sandrews/freETarget/KiCad/Main Board/Electronic Target V3.sch

## KiCad design KiCad/Main Board/Electronic Target V3.sch (2021-02-10)

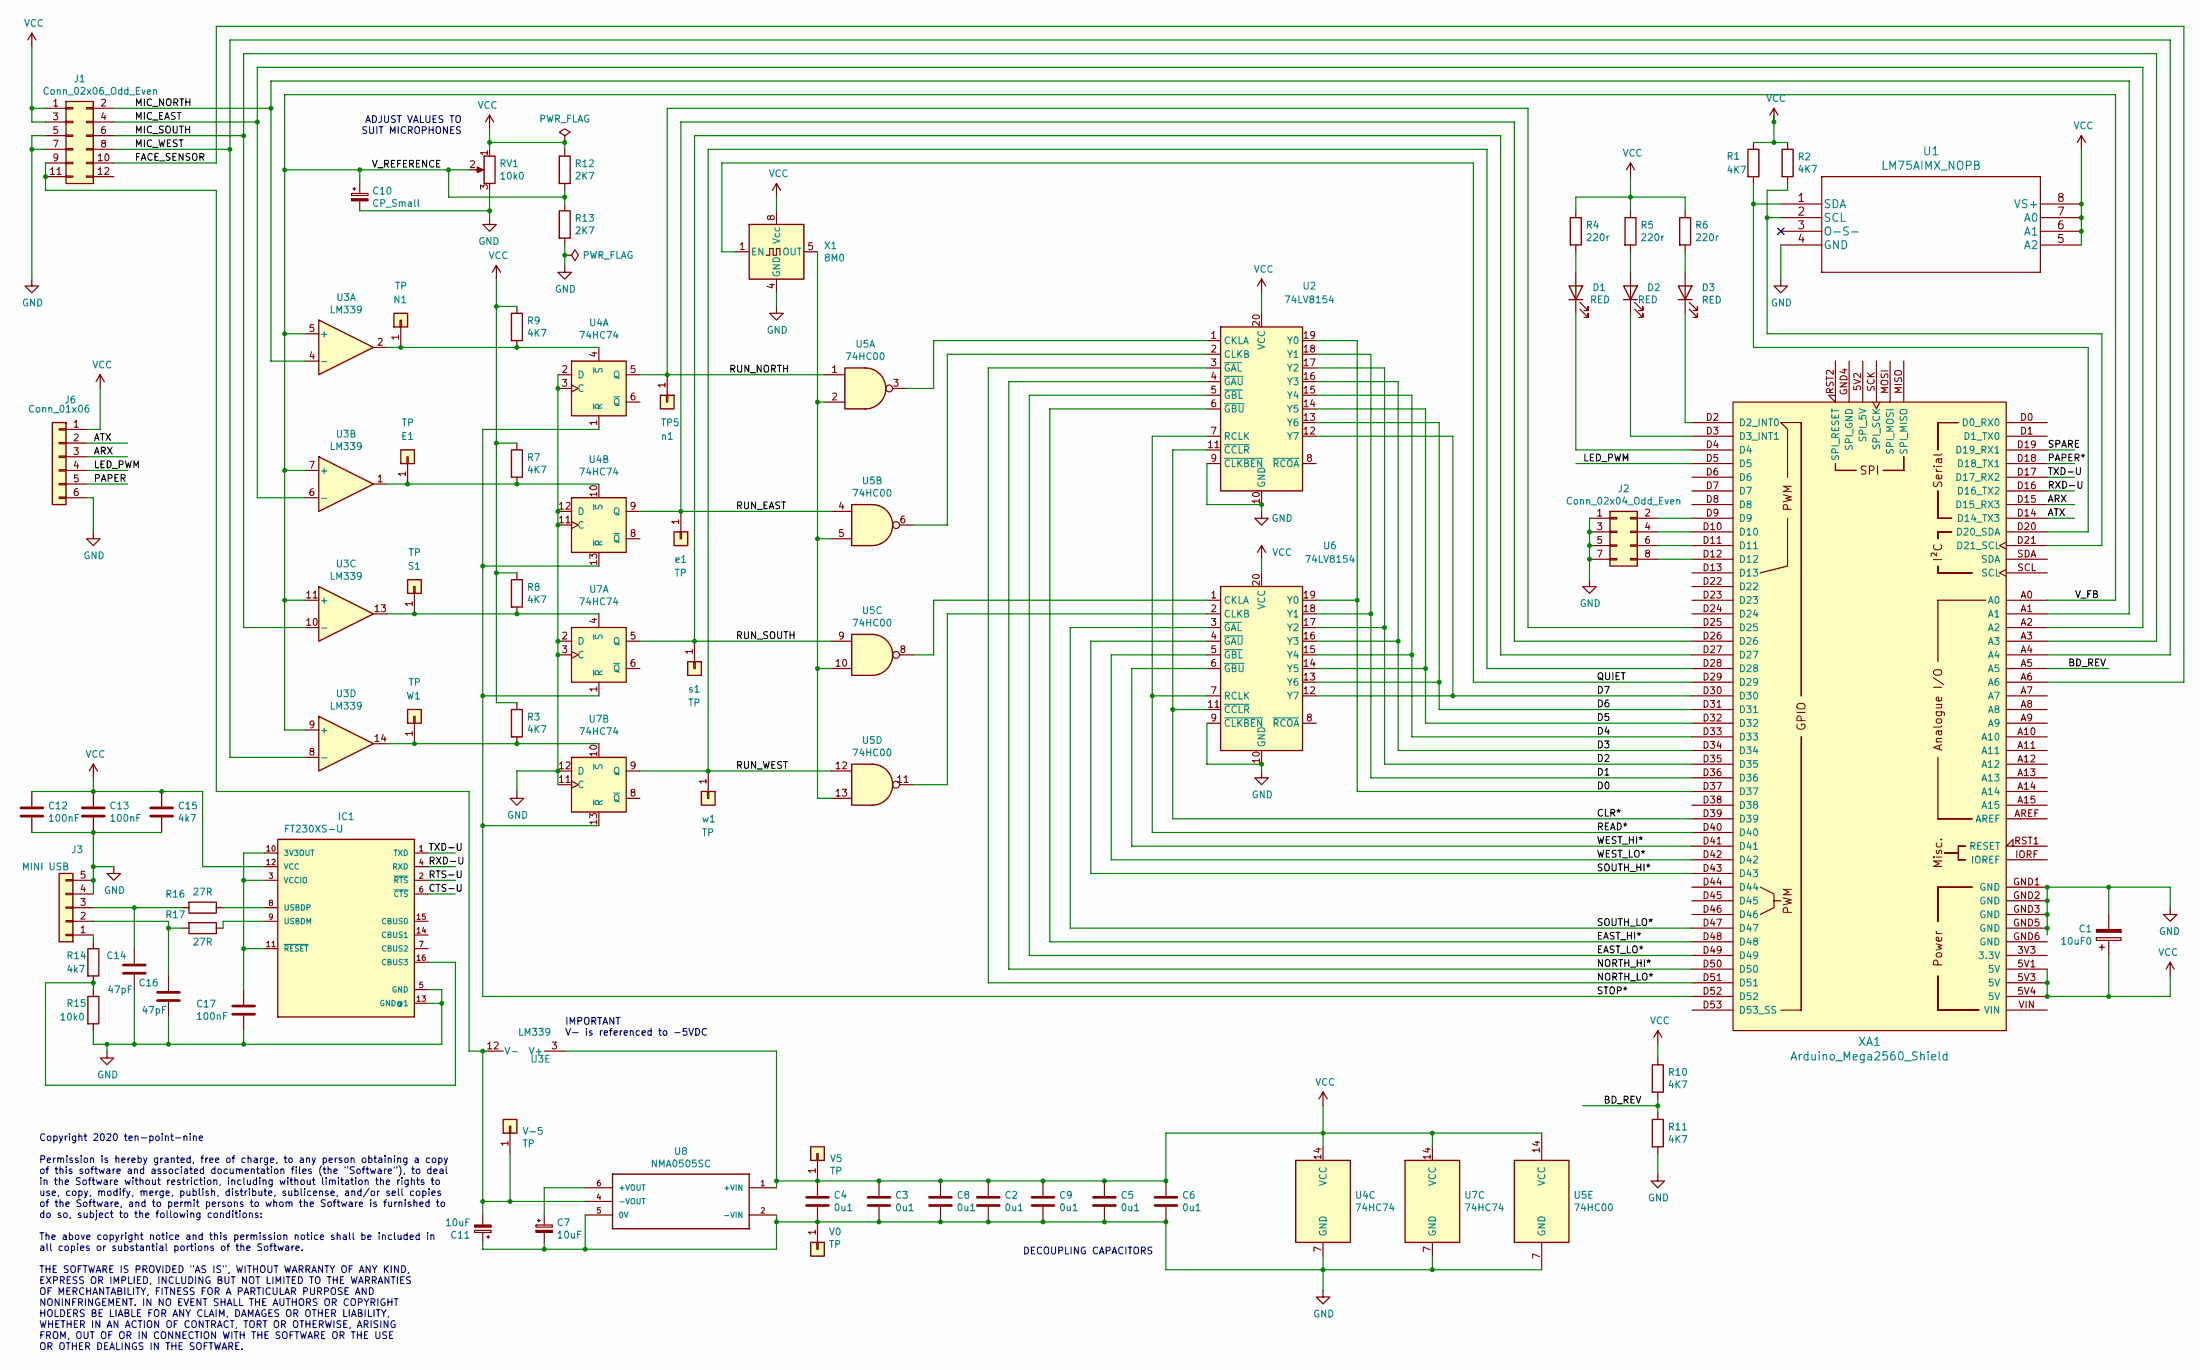
[picture p3: schematic Electronic Target V3.sch]

Parts:
C1: 10uF0; R_1210_3225Metric
C2, C3, C4, C5, C6, C8, C9: 0u1; R_0805_2012Metric
C7: 10uF; R_1206_3216Metric; Digikey 478-10742-1-ND
C10: CP_Small; R_1206_3216Metric
C11: 10uF; R_1206_3216Metric; DigiKey 478-10742-1-ND
C12, C13, C17: 100nF
C14, C16: 47pF
C15: 4k7
D1, D2, D3: RED; R_1210_3225Metric
E1: TP; PinHeader_1x01_P2.54mm_Vertical
IC1: FT230XS-U; SSOP16
J1: Conn_02x06_Odd_Even
J2: Conn_02x04_Odd_Even; PinHeader_2x04_P2.54mm_Vertical
J3: MINI USB
J6: Conn_01x06
N1: TP; PinHeader_1x01_P2.54mm_Vertical
R1, R2, R10, R11: 4K7; R_0805_2012Metric
R3, R7, R8, R9: 4K7; R_0805_2012Metric; DigiKey 311-4.70KCRCT-ND
R4, R5, R6: 220r; R_0805_2012Metric; DigiKey A126351CT-ND
R12, R13: 2K7; R_0805_2012Metric
R14: 4k7
R15: 10k0
R16, R17: 27R
RV1: 10k0; 23BR10KLFTR; DigiKey 987-1014-1-ND
S1: TP; PinHeader_1x01_P2.54mm_Vertical
TP5: n1; PinHeader_1x01_P2.54mm_Vertical
U1: LM75AIMX_NOPB; SOIC-8_3.9x4.9mm_P1.27mm
U2, U6: 74LV8154; TSSOP-20_4.4x6.5mm_P0.65mm; DigiKey 296-47353-1-ND
U3: LM339; DigiKey 293-1013-1-ND
U4, U7: 74HC74; SOIC-14_3.9x8.7mm_P1.27mm; DigiKey 296-1204-1-ND
U5: 74HC00; SOIC-14_3.9x8.7mm_P1.27mm; DigiKey 296-1187-1-ND
U8: NMA0505SC; SIP600W50P254L1950H1000Q5
V0, V5: TP; PinHeader_1x01_P2.54mm_Vertical
V-5: TP; PinHeader_1x01_P2.54mm_Vertical
W1: TP; PinHeader_1x01_P2.54mm_Vertical
X1: 8M0; DIP-8_W7.62mm; DigiKey 110-MXO45HST-3C-8M000000-ND
XA1: Arduino_Mega2560_Shield; Arduino_Mega2560_Shield_AMB
e1: TP; PinHeader_1x01_P2.54mm_Vertical
s1: TP; PinHeader_1x01_P2.54mm_Vertical
w1: TP; PinHeader_1x01_P2.54mm_Vertical

Connections:
ARX: J6.3, XA1.D15 (D15_RX3)
ATX: J6.2, XA1.D14 (D14_TX3)
BD_REV: R10.2, R11.1, XA1.A5
CLR*: U2.11 (~CCLR), U6.11 (~CCLR), XA1.D39
CTS-U: IC1.6 (~CTS)
D0: U2.19 (Y0), U6.19 (Y0), XA1.D37
D1: U2.18 (Y1), U6.18 (Y1), XA1.D36
D2: U2.17 (Y2), U6.17 (Y2), XA1.D35
D3: U2.16 (Y3), U6.16 (Y3), XA1.D34
D4: U2.15 (Y4), U6.15 (Y4), XA1.D33
D5: U2.14 (Y5), U6.14 (Y5), XA1.D32
D6: U2.13 (Y6), U6.13 (Y6), XA1.D31
D7: U2.12 (Y7), U6.12 (Y7), XA1.D30
EAST_HI*: U2.6 (~GBU), XA1.D48
EAST_LO*: U2.5 (~GBL), XA1.D49
FACE_SENSOR: J1.10, XA1.A6
GND: C1.2, C2.2, C3.2, C4.2, C5.2, C6.2, C7.2, C8.2, C9.2, C10.2, C11.1, C12.2, C13.2, C14.2, C15.2, C16.2, C17.2, IC1.5 (GND), IC1.13 (GND@1), J1.5, J1.7, J2.1, J2.3, J2.5, J2.7, J3.4, J3.5, J6.6, R11.2, R13.2, R15.2, RV1.3, U1.4 (GND), U2.9 (~CLKBEN), U2.10 (GND), U4.2 (D), U4.3 (C), U4.7 (GND), U4.11 (C), U4.12 (D), U5.7 (GND), U6.9 (~CLKBEN), U6.10 (GND), U7.2 (D), U7.3 (C), U7.7 (GND), U7.11 (C), U7.12 (D), U8.2 (-VIN), U8.5 (0V), V0.1, X1.4 (GND), XA1.GND1 (GND), XA1.GND2 (GND), XA1.GND3 (GND), XA1.GND5 (GND)
LED_PWM: J6.4, XA1.D5
MIC_EAST: J1.4, U3.6 (-), XA1.A2
MIC_NORTH: J1.2, U3.4 (-), XA1.A1
MIC_SOUTH: J1.6, U3.10 (-), XA1.A3
MIC_WEST: J1.8, U3.8 (-), XA1.A4
NORTH_HI*: U2.4 (~GAU), XA1.D50
NORTH_LO*: U2.3 (~GAL), XA1.D51
unnamed: C7.1, U8.6 (+VOUT)
unnamed: C11.2, J1.9, J1.11, U3.12 (V-), U8.4 (-VOUT), V-5.1
unnamed: C14.1, J3.3, R16.2
unnamed: C16.1, J3.2, R17.2
unnamed: C17.1, IC1.3 (VCCIO), IC1.10 (3V3OUT), IC1.11 (~RESET)
unnamed: D1.1 (K), XA1.D4
unnamed: D1.2 (A), R4.2
unnamed: D2.1 (K), XA1.D3 (D3_INT1)
unnamed: D2.2 (A), R5.2
unnamed: D3.1 (K), XA1.D2 (D2_INT0)
unnamed: D3.2 (A), R6.2
unnamed: E1.1, R7.2, U3.1, U4.10 (~S)
unnamed: IC1.8 (USBDP), R16.1
unnamed: IC1.9 (USBDM), R17.1
unnamed: IC1.16 (CBUS3), R14.2, R15.1
unnamed: J2.2, XA1.D9
unnamed: J2.4, XA1.D10
unnamed: J2.6, XA1.D11
unnamed: J2.8, XA1.D12
unnamed: J3.1, R14.1
unnamed: N1.1, R9.2, U3.2, U4.4 (~S)
unnamed: R1.2, U1.1 (SDA), XA1.D20 (D20_SDA)
unnamed: R2.2, U1.2 (SCL), XA1.D21 (D21_SCL)
unnamed: R3.2, U3.14, U7.10 (~S), W1.1
unnamed: R8.2, S1.1, U3.13, U7.4 (~S)
unnamed: U2.1 (CKLA), U5.3
unnamed: U2.2 (CLKB), U5.6
unnamed: U5.8, U6.1 (CKLA)
unnamed: U5.2, U5.5, U5.10, U5.13, X1.5 (OUT)
unnamed: U5.11, U6.2 (CLKB)
PAPER: J6.5
PAPER*: XA1.D18 (D18_TX1)
QUIET: X1.1 (EN), XA1.D29
READ*: U2.7 (RCLK), U6.7 (RCLK), XA1.D40
RTS-U: IC1.2 (~RTS)
RUN_EAST: U4.9 (Q), U5.4, XA1.D26, e1.1
RUN_NORTH: TP5.1, U4.5 (Q), U5.1, XA1.D25
RUN_SOUTH: U5.9, U7.5 (Q), XA1.D27, s1.1
RUN_WEST: U5.12, U7.9 (Q), XA1.D28, w1.1
RXD-U: IC1.4 (RXD), XA1.D16 (D16_TX2)
SOUTH_HI*: U6.4 (~GAU), XA1.D43
SOUTH_LO*: U6.3 (~GAL), XA1.D47
SPARE: XA1.D19 (D19_RX1)
STOP*: U4.1 (~R), U4.13 (~R), U7.1 (~R), U7.13 (~R), XA1.D52
TXD-U: IC1.1 (TXD), XA1.D17 (D17_RX2)
VCC: C1.1, C2.1, C3.1, C4.1, C5.1, C6.1, C8.1, C9.1, C12.1, C13.1, C15.1, IC1.12 (VCC), J1.1, J1.3, J6.1, R1.1, R2.1, R3.1, R4.1, R5.1, R6.1, R7.1, R8.1, R9.1, R10.1, R12.1, RV1.1, U1.5 (A2), U1.6 (A1), U1.7 (A0), U1.8 (VS+), U2.20 (VCC), U3.3 (V+), U4.14 (VCC), U5.14 (VCC), U6.20 (VCC), U7.14 (VCC), U8.1 (+VIN), V5.1, X1.8 (Vcc), XA1.5V1 (5V), XA1.5V3 (5V), XA1.5V4 (5V)
V_FB: C10.1, R12.2, R13.1, RV1.2, U3.5 (+), U3.7 (+), U3.9 (+), U3.11 (+), XA1.A0
WEST_HI*: U6.6 (~GBU), XA1.D41
WEST_LO*: U6.5 (~GBL), XA1.D42

Notes on the sheet:
ADJUST VALUES TO SUIT MICROPHONES
DECOUPLING CAPACITORS
Copyright 2020 ten-point-nine Permission is hereby granted, free of charge, to any person obtaining a copy of this software and associated documentation files (the "Software"), to deal in the Software without restriction, including without limitation the rights to use, copy, modify, merge, publish,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
IMPORTANT V- is referenced to -5VDC
