sandrews/freETarget/Software/Arduino/freETarget/analog_io.h

/*
 * Global functions
 */

void init_analog_io(void);          // Setup the analog hardware
unsigned int read_reference(void);  // Read the feedback channel
void show_analog(void);             // Display the analog values
void cal_analog(void);              // Calibrate the analog threshold
double temperature_C(void);         // Temperature in degrees C
unsigned int revision(void);        // Return the board revision
void set_LED_PWM(void);             // Set the PWM duty cycle

/*
 *  Port Definitions
 */

#define NORTH_ANA    1          // North Analog Input
#define EAST_ANA     2          // East Analog Input
#define SOUTH_ANA    3          // South Analog Input
#define WEST_ANA     4          // West Analog Input

#define SPARE_2A     7          // Not Used
#define V_REFERENCE  0          // Reference Input
#define ANALOG_VERSION 5        // Analog Version Input
#define LED_PWM      5          // PWM Port

#define TO_VOLTS(x) ( ((double)(x) * 5.0) / 1024.0 )

#define TEMP_IC   (0x9E >> 1)
